samyk/dingdong/schematic.png

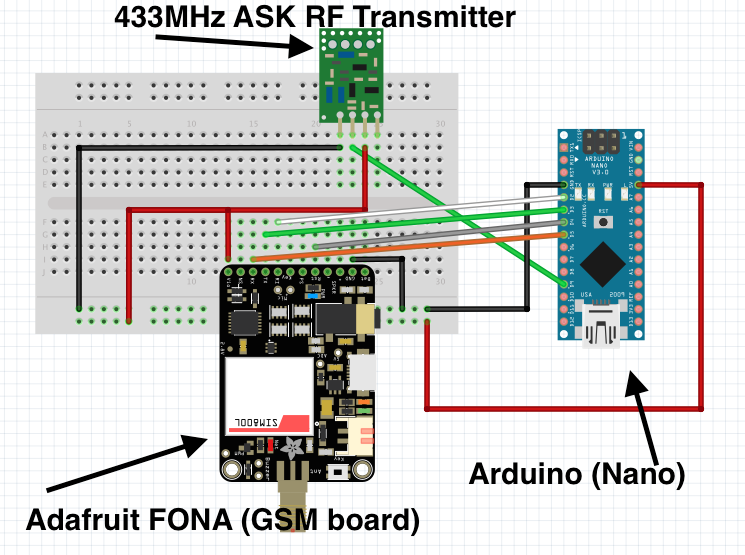
schematic.png
